HARSH1911RATHORE/ESD-Final-Project/SCHEMATICS/ESD_FINAL_PROJECT_SCHEMATICS.pdf

# VCC GND

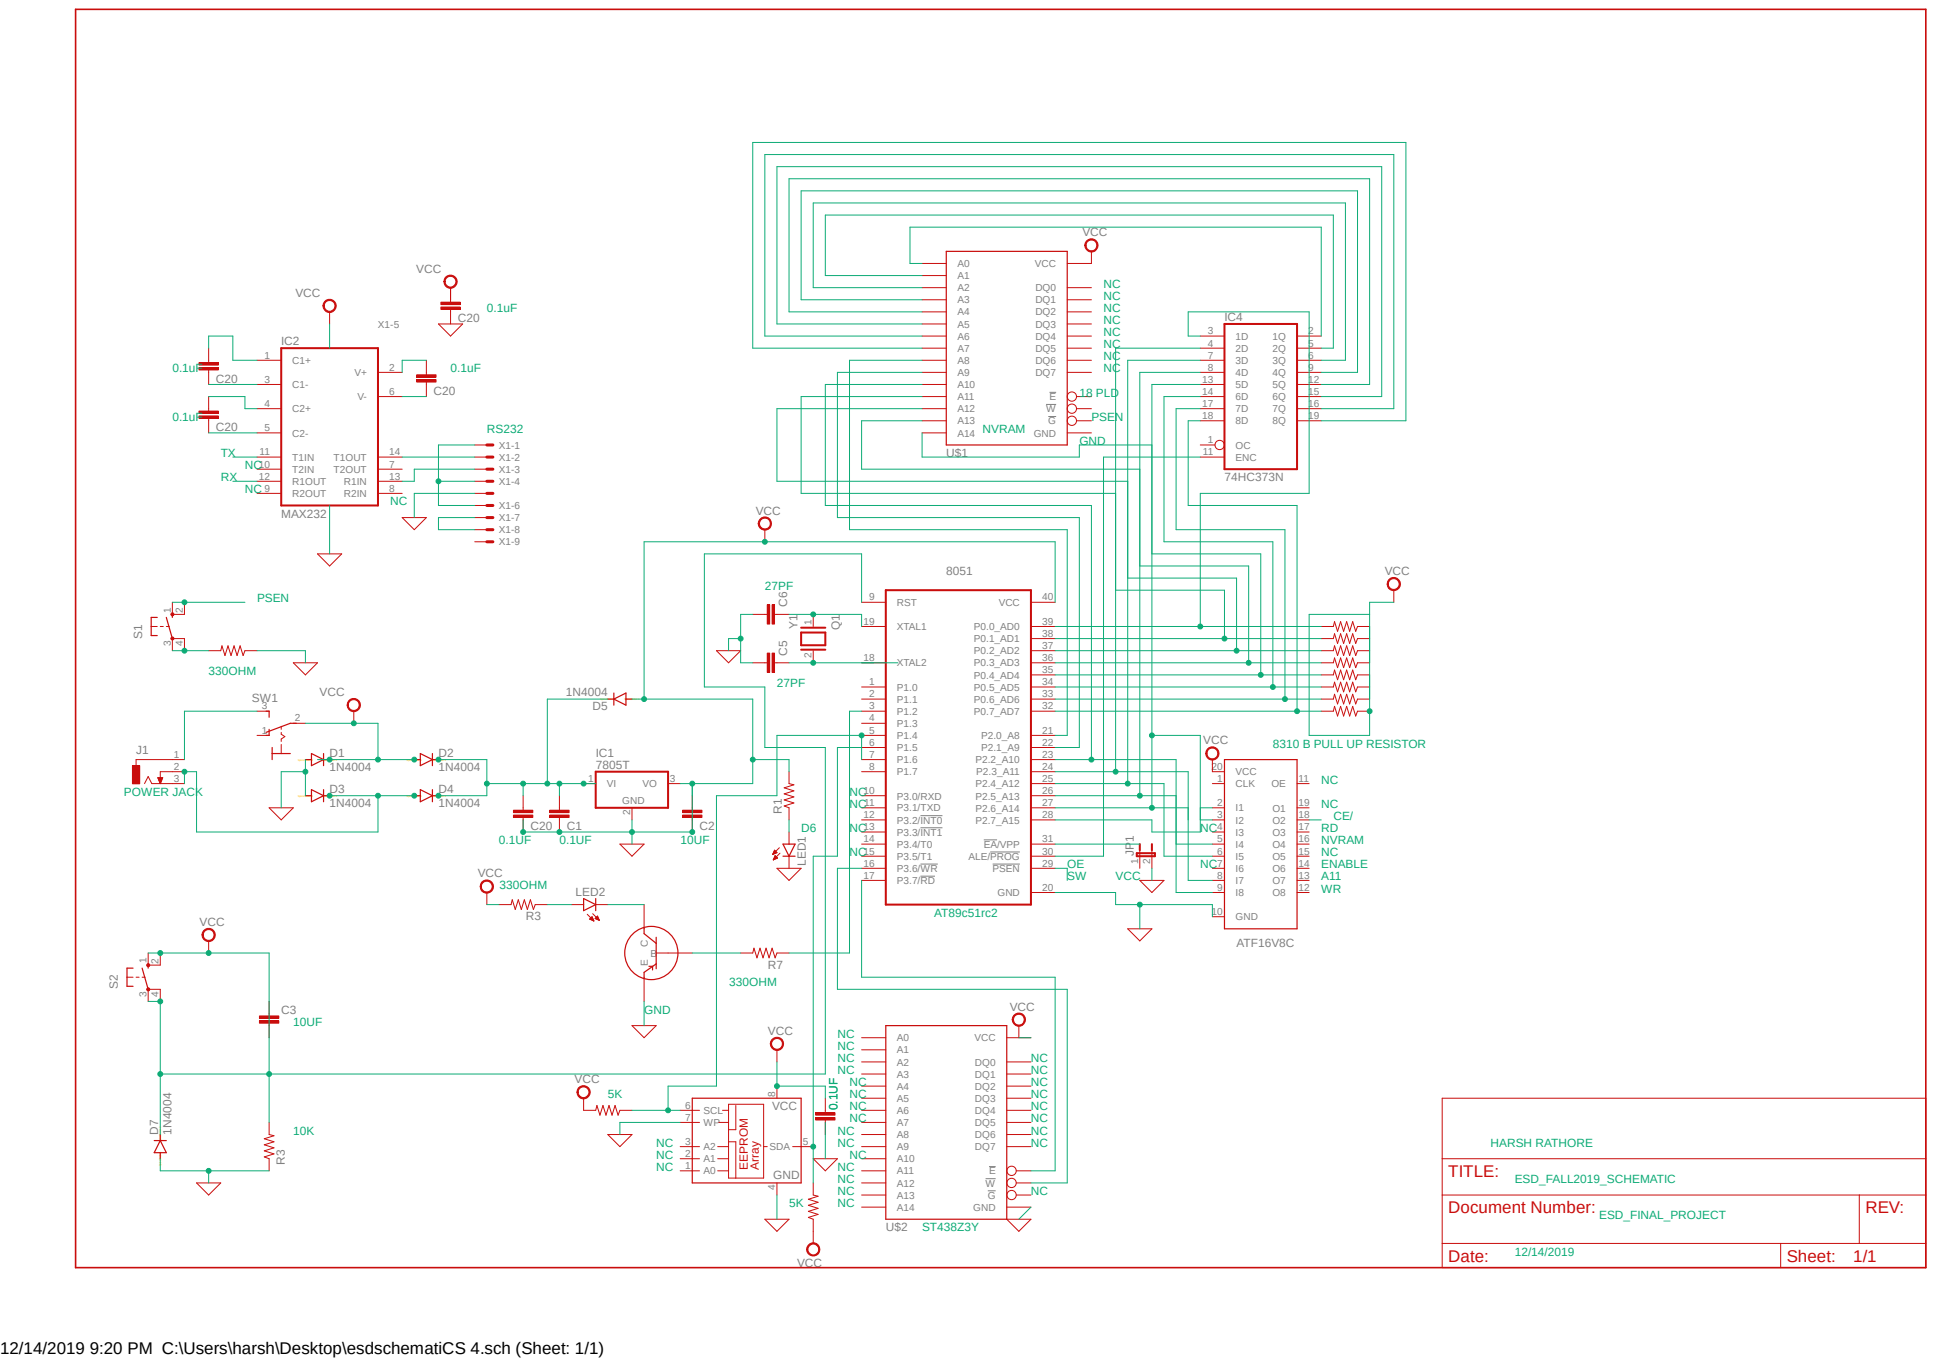
[picture p22: page 1]

Document Number: ESD_FINAL_PROJECT | REV:

Date: 12/14/2019 | Sheet:

12/14/2019 9:20 PM C:\Users\harsh\Desktop\esdschematiCS 4.sch (Sheet: 1/1)
