HARSH1911RATHORE/ESD-Final-Project/SCHEMATICS/ESD_FINAL_PROJECT_SCHEMATICS 2.pdf

12/14/2019 9:16 PM C:\Users\harsh\Desktop\ESD_LAB4_PART2.sch (Sheet: 1/1) TUXGR_16X²_R² | VCCVCC | VCC
VDD | 1 SCLK | 2 SDIN | 3 D/C | 4

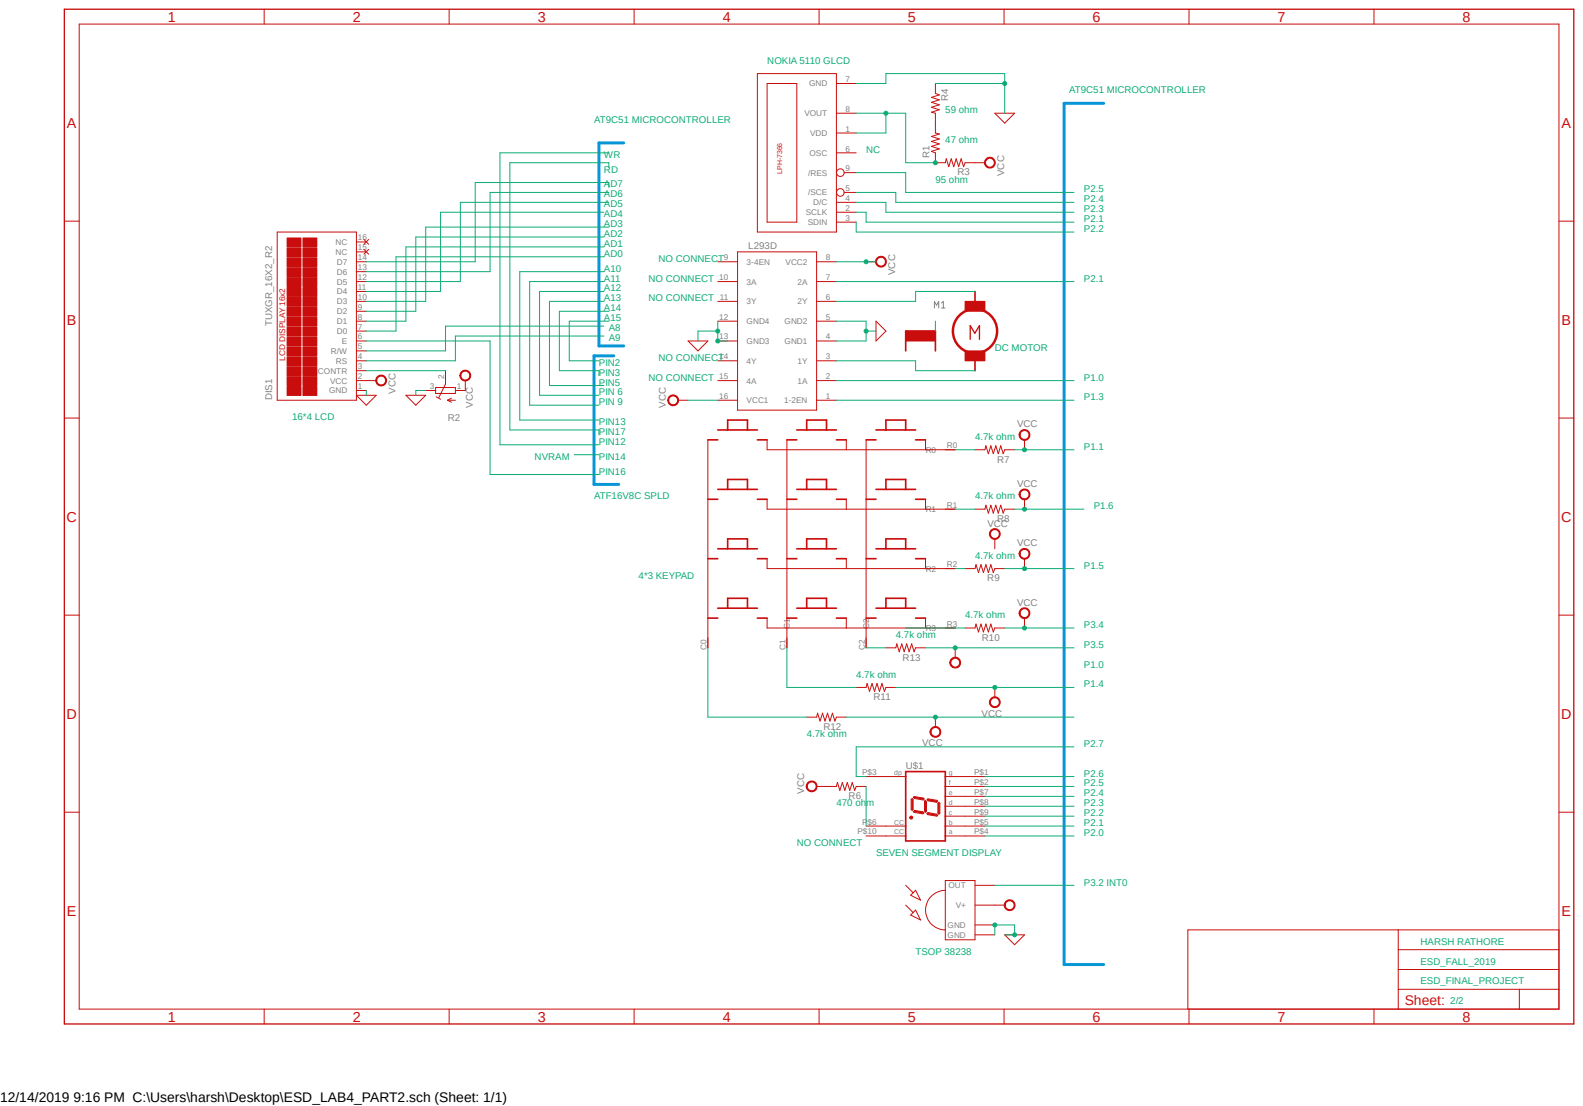
[picture p23: page 1]
