HARSH1911RATHORE/ESD-Final-Project/SCHEMATICS/ESD_FINAL_SCHEMATICS1.sch

## EAGLE design SCHEMATICS/ESD_FINAL_SCHEMATICS1.sch (2021-02-16)

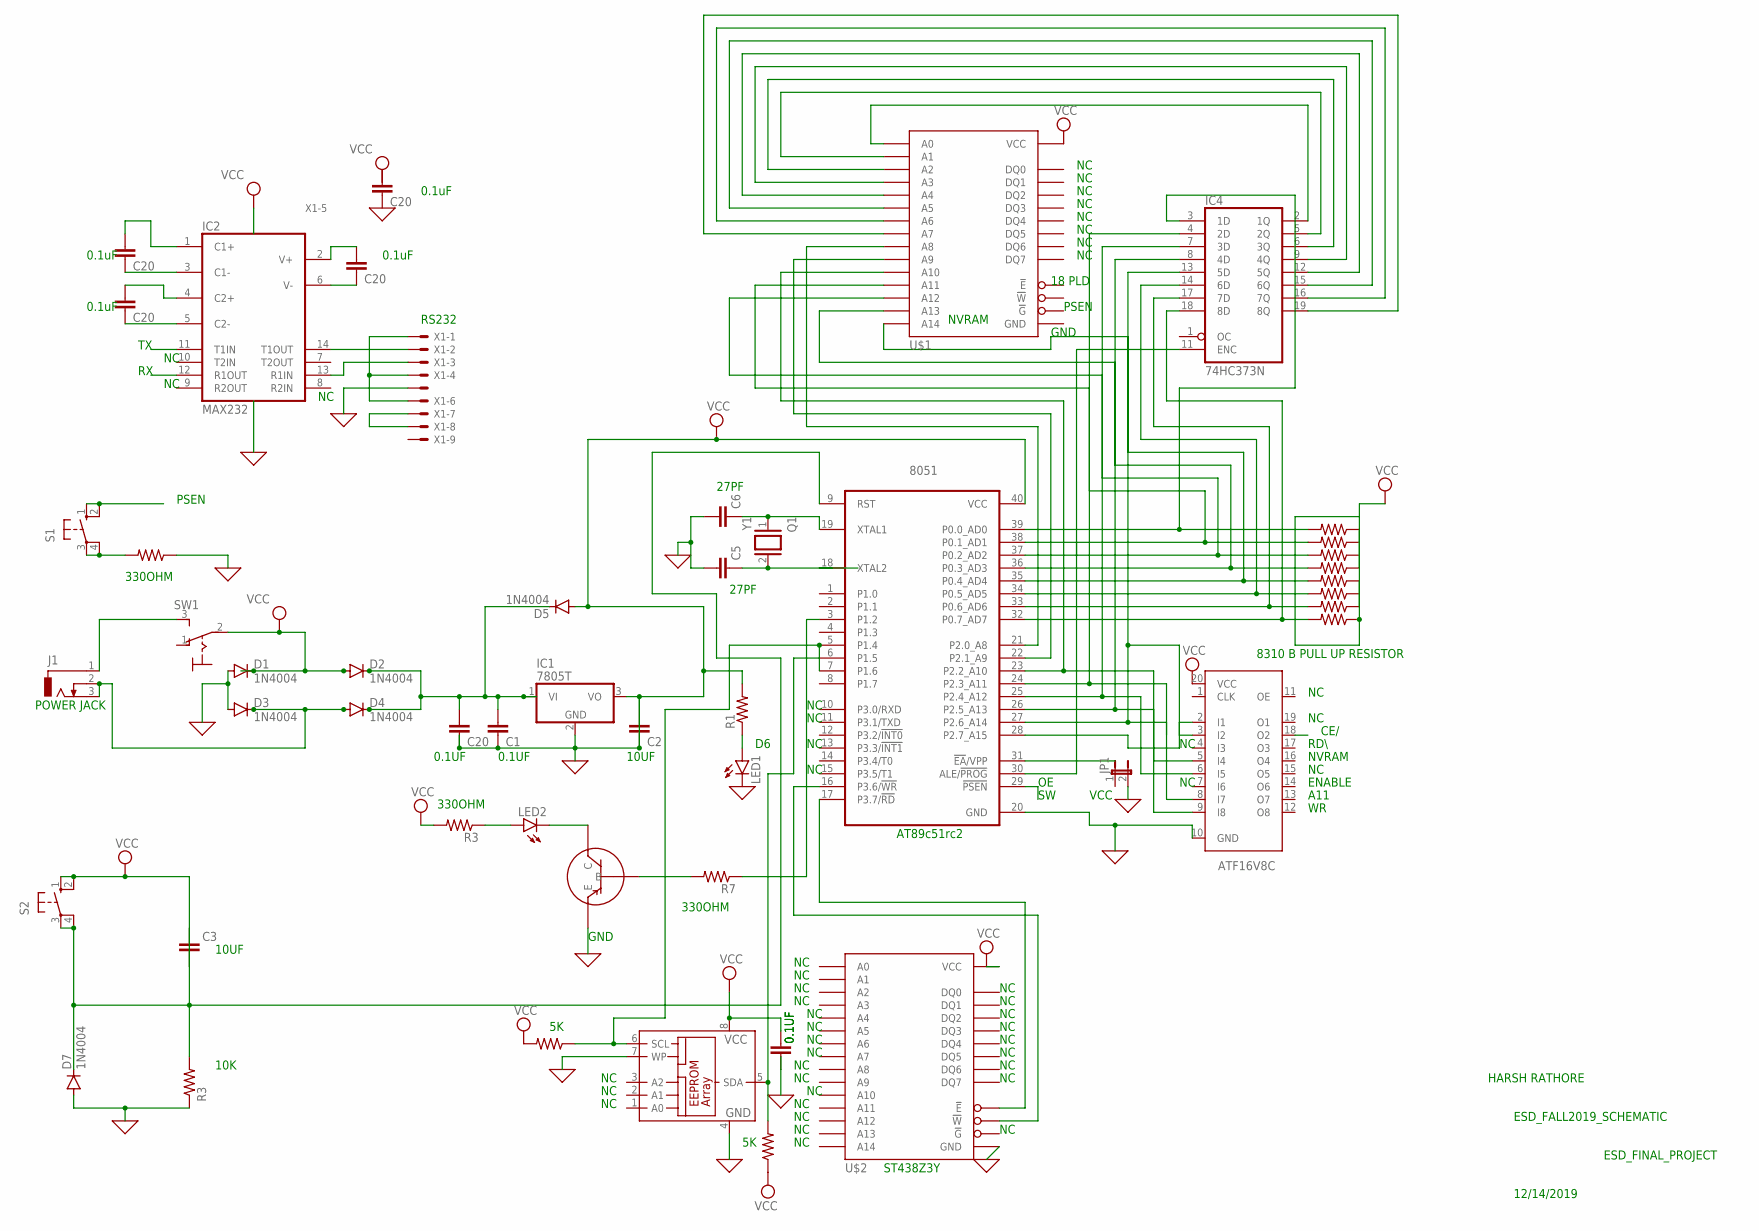
[picture p24: schematic ESD_FINAL_SCHEMATICS1.sch]

Parts:
8051: SAB-C501G; DIL40
ATF16V8C: ATF16V8BJ; PLCC20
C1: C6; C2.5-3
C2: C2,5-3; C2.5-3
C3, C4, C7, C9, C10, C31: C20; C2.5-3
C5: C1; C2.5-3
C6: C2; C2.5-3
C8: C5; C2.5-3
D1, D2, D3, D4, D5, D7: 1N4004; DO41-10
IC1: 7805T; TO220H
IC2: MAX232; DIL16
IC3: 24C01CP; DIL8
IC4: 74HC373N; DIL20
J1: POWER JACK; DCJ0202
JP1: JP1E; JP1
LED1, LED2: D6; LZ1-00WW03
PULLUPRESISTORS: R-US_0204/2V; 0204V
Q1: Y1; Q
R1, R3, R4, R5, R6, R7, R8, R9, R10, R11, R12, R13, R14: R-US_0204/2V; 0204V
R2: R3; 0204V
S1, S2: 10-XX; B3F-10XX
SW1: SW1; 320-916
U$1, U$2: M48Z35Y; RANDOM_DO_NOT_USE
X1: 22-23-2091

Connections:
0: 8051.20 (GND), ATF16V8C.10 (GND), C1.1, C8.1, C9.2, C10.2, D1.A, D3.A, D7.A, IC3.4 (GND), IC3.7 (WP), JP1.2, LED1.1 (C), R2.1, R12.1, U$2.P$27 (GND), X1.5
C3: 8051.9 (RST), C2.1, C2.2, D7.C, R2.2, S2.1 (S), S2.2 (S1), S2.3, S2.4 (P1)
unnamed: 8051.19 (XTAL1), C1.2, Q1.1
unnamed: D3.C, D4.A, J1.2, J1.3
unnamed: J1.1, SW1.3 (S)
unnamed: LED1.2 (A), R1.1
unnamed: IC4.19 (8Q), U$1.P$11 (A7)
unnamed: C3.1, IC2.1 (C1+)
unnamed: IC4.2 (1Q), U$1.P$4 (A0)
unnamed: 8051.17 (P3.7/!RD), U$2.P$1 (!E)
unnamed: 8051.26 (P2.5_A13), ATF16V8C.5 (I4), U$1.P$17 (A13)
unnamed: 8051.27 (P2.6_A14), ATF16V8C.3 (I2), U$1.P$18 (A14)
unnamed: 8051.16 (P3.6/!WR), U$2.P$3 (!W)
unnamed: 8051.32 (P0.7_AD7), IC4.18 (8D), R11.2
unnamed: 8051.33 (P0.6_AD6), IC4.17 (7D), R10.2
unnamed: R8.1, R9.1, R10.1
unnamed: 8051.24 (P2.3_A11), ATF16V8C.8 (I7), U$1.P$15 (A11)
unnamed: 8051.25 (P2.4_A12), ATF16V8C.6 (I5), U$1.P$16 (A12)
unnamed: 8051.3 (P1.2), R7.1
unnamed: PULLUPRESISTORS.1, R4.1, R5.1, R6.1
unnamed: 8051.6 (P1.5), IC3.5 (SDA), R14.2
unnamed: C5.1, C31.1, D2.C, D4.C, D5.C, IC1.1 (VI)
unnamed: 8051.5 (P1.4), 8051.7 (P1.6), IC3.6 (SCL), R13.1
unnamed: 8051.30 (ALE/!PROG), IC4.11 (ENC)
unnamed: LED2.2 (A), R3.1
unnamed: IC4.16 (7Q), U$1.P$10 (A6)
unnamed: 8051.21 (P2.0_A8), U$1.P$12 (A8)
unnamed: C8.2, Q1.2
unnamed: C3.2, IC2.3 (C1-)
unnamed: 8051.23 (P2.2_A10), ATF16V8C.9 (I8), U$1.P$14 (A10)
unnamed: C4.1, IC2.4 (C2+)
unnamed: 8051.22 (P2.1_A9), U$1.P$13 (A9)
unnamed: 8051.34 (P0.5_AD5), IC4.14 (6D), R9.2
unnamed: C4.2, IC2.5 (C2-)
unnamed: 8051.35 (P0.4_AD4), IC4.13 (5D), R8.2
unnamed: 8051.36 (P0.3_AD3), IC4.8 (4D), PULLUPRESISTORS.2
unnamed: 8051.37 (P0.2_AD2), IC4.7 (3D), R4.2
unnamed: 8051.38 (P0.1_AD1), IC4.4 (2D), R6.2
unnamed: 8051.39 (P0.0_AD0), IC4.3 (1D), R5.2
unnamed: C7.1, IC2.2 (V+)
unnamed: IC2.14 (T1OUT), X1.2
unnamed: IC2.13 (R1IN), X1.3
unnamed: X1.1, X1.4, X1.6
unnamed: C7.2, IC2.6 (V-)
unnamed: X1.7, X1.8
unnamed: S1.1 (S), S1.2 (S1)
unnamed: R12.2, S1.3, S1.4 (P1)
unnamed: 8051.28 (P2.7_A15), ATF16V8C.2 (I1)
unnamed: IC4.12 (5Q), U$1.P$8 (A4)
unnamed: IC4.5 (2Q), U$1.P$5 (A1)
unnamed: IC4.9 (4Q), U$1.P$7 (A3)
unnamed: IC4.15 (6Q), U$1.P$9 (A5)
unnamed: IC4.6 (3Q), U$1.P$6 (A2)
VCC: 8051.40 (VCC), ATF16V8C.20 (VCC), C5.2, C6.1, C6.2, C10.1, C31.2, D1.C, D2.A, D5.A, IC1.2 (GND), IC1.3 (VO), IC3.8 (VCC), R1.2, R3.2, R11.1, R13.2, R14.1, SW1.2, U$1.P$28 (VCC), U$2.P$28 (VCC)

Notes on the sheet:
8310 B PULL UP RESISTOR
POWER JACK
10K
10UF
27PF
0.1UF
PSEN
18 PLD
GND
NVRAM
0.1uF
CE/
VCC
330OHM
AT89c51rc2
ST438Z3Y
HARSH RATHORE
ESD_FALL2019_SCHEMATIC
RS232
RD\
A11
ENABLE
ESD_FINAL_PROJECT
12/14/2019
