HARSH1911RATHORE/ESD-Final-Project/SCHEMATICS/ESD_FINAL_SCHEMATICS2.sch

## EAGLE design SCHEMATICS/ESD_FINAL_SCHEMATICS2.sch (2021-02-16)

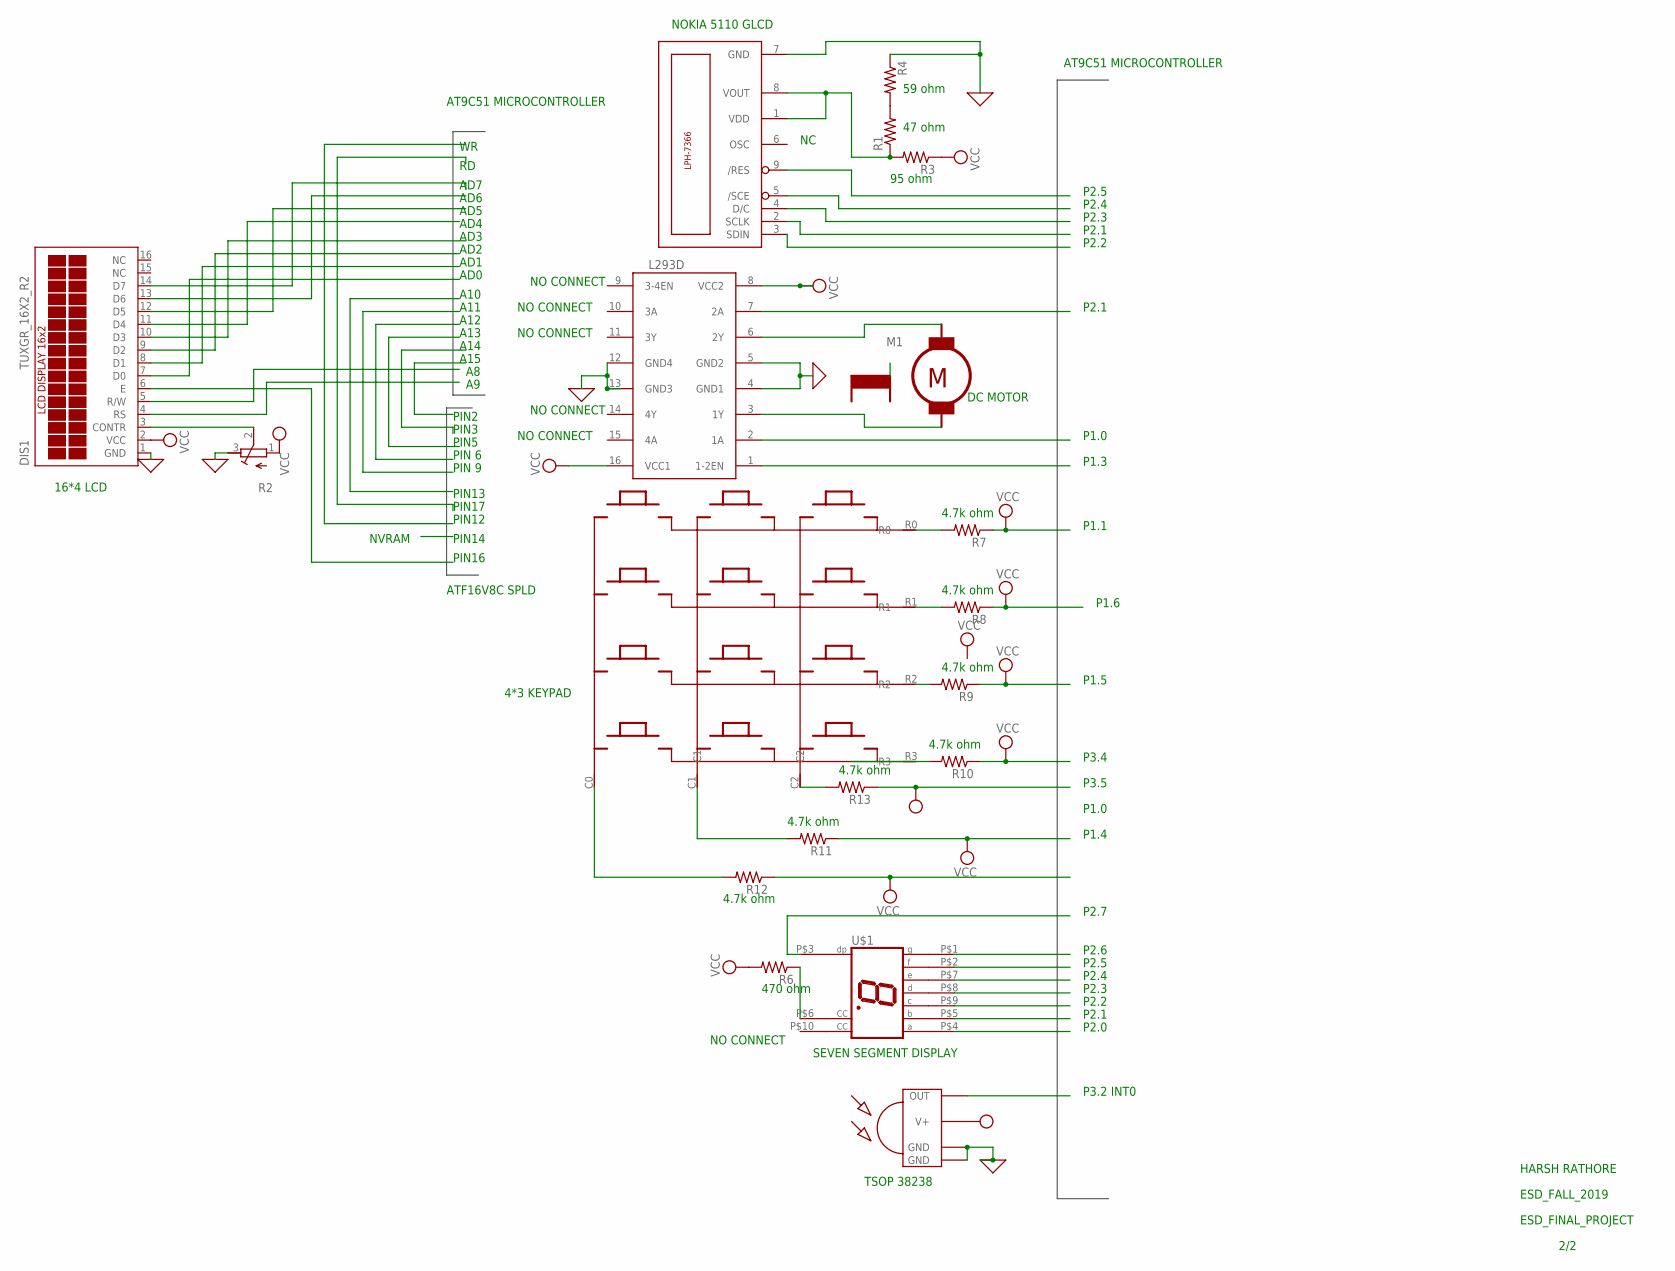
[picture p25: schematic ESD_FINAL_SCHEMATICS2.sch]

Parts:
DIS1: TUXGR_16X2_R2
IC1: L293D; DIL16
KP1: KEYPAD
LCD3: LPH-7366
M1: MOTOR_DC_2_XL; 4PIN
R1, R3, R4, R6, R7, R8, R9, R10, R11, R12, R13: R-US_0204/2V; 0204V
R2: R-TRIMM4G/J; RTRIM4G/J
U$1: JUMBOLED
U$2: TSOP62XX

Connections:
0: DIS1.1 (GND), IC1.4 (GND1), IC1.5 (GND2), IC1.12 (GND4), IC1.13 (GND3), LCD3.7 (GND), R2.3 (E), R4.1, U$2.1 (GND), U$2.2 (GND)
unnamed: DIS1.3 (CONTR), R2.2 (S)
unnamed: LCD3.1 (VDD), LCD3.8 (VOUT), R1.1, R3.2
unnamed: R1.2, R4.2
unnamed: IC1.6 (2Y), M1.2
unnamed: IC1.3 (1Y), M1.1
unnamed: KP1.C1, R11.2
unnamed: KP1.C0, R12.2
unnamed: R6.1, U$1.P$6 (CC)
unnamed: KP1.R0, R7.2
unnamed: KP1.R1, R8.2
unnamed: KP1.R2, R9.2
unnamed: KP1.R3, R10.2
unnamed: KP1.C2, R13.2
VCC: DIS1.2 (VCC), IC1.8 (VCC2), IC1.16 (VCC1), R2.1 (A), R3.1, R6.2, R7.1, R8.1, R9.1, R10.1, R11.1, R12.1, R13.1, U$2.3 (V+)

Notes on the sheet:
AD3
AD4
AD5
AD6
AD7
A12
A13
A14
A15
PIN2
PIN3
PIN5
PIN 6
PIN 9
PIN13
PIN17
AD2
AD1
AD0
PIN12
A10
A11
PIN16
PIN14
NVRAM
ATF16V8C SPLD
AT9C51 MICROCONTROLLER
47 ohm
59 ohm
95 ohm
P2.5
P2.4
P2.3
P2.2
P2.1
P1.0
P1.3
P1.1
P1.6
P1.5
P3.4
P3.5
P1.4
P2.0
P2.6
P2.7
470 ohm
4.7k ohm
NO CONNECT
NOKIA 5110 GLCD
16*4 LCD
P3.2 INT0
ESD_FALL_2019
ESD_FINAL_PROJECT
HARSH RATHORE
2/2
4*3 KEYPAD
TSOP 38238
SEVEN SEGMENT DISPLAY
DC MOTOR
