HARSH1911RATHORE/ESD-Final-Project/(notices)

Notices in the files:
parts and their libraries:
schule_xl: © by Ralf Stutzenberger
